nomatin/USB-RS485-Dongle/Docs/Световод цилиндрический XXXX.755453.001.pdf

### 1. Изготовить из прозрачного бесцветного прутка

полиметилметакрилата.
2.Неуказанные предельные отклонения линейных размеров — по ГОСТ 30893.1-2002, класс m.

### 3. Торцевые поверхности отполировать до оптической

прозрачности.
4.Царапины, сколы, трещины и помутнения, ухудшающие светопропускание, не допускаются.
5. Боковую цилиндрическую поверхность оставить без обработки. 6.Заусенцы на торцах удалить, не нарушая геометрии детали.

Инв.№ подл. Подп.

и дата Взам.инв.№ Инв.№ дубл. Подп.

и дата

Н. контр. | Попов
Утв. | Лыткин
Копировал | Формат

Справ.

№

| | | | XXXX.755453.001
| | | | Световод цилиндрический | Лит. | Масса | Масштаб
Изм. Лист № докум. | | Подп. | Дата | | | | | 0.04 г | 4:1
Разраб. | Иванов
| Пров. | Смирнов
Т.контр. | | | | Лист | Листов 1
| | | Полиметилметакрилат

Перв. примен.

XXXX.468352.001

A4

2

11
