nomatin/USB-RS485-Dongle/Board/OUTPUT/Manufacturing/BOM/Bill of Materials-USB_to_RS485.xlsx

Comment | Description | Designator | Package | Manufacturer | MPN | Quantity
100 нФ | Конденсатор 100 нФ ±20% 100 В X7R 0805, Конденсатор 100 нФ ±10% 100 В X7R 0805 | C1, C2, C4, C9, C10 | 0805 | YAGEO | CC0805MKX7R0BB104, CC0805KKX7R0BB104 | 5
4,7 мкФ | Конденсатор 4,7 мкФ ±20% 25 В X7R 0805 | C3, C5 | 0805 | YAGEO | CC0805MKX7R8BB475 | 2
10 мкФ | Конденсатор 10 мкФ ±20% 16 В X7R 0805 | C6, C13, C14 | 0805 | YAGEO | CC0805MKX7R7BB106 | 3
1 мкФ | Конденсатор 1 мкФ ±20% 100 В X7R 0805 | C7, C12 | 0805 | YAGEO | CC0805MKX7R0BB105 | 2
10 нФ | Конденсатор 10 нФ ±10% 100 В X7R 0603 | C8, C11 | 0603 | YAGEO | CC0603KRX7R0BB103 | 2
USBLC6-2SC6 | Микросхема USBLC6-2SC6 | D1 | SOT23-6L | STMicroelectronics | USBLC6-2SC6 | 1
CDSOT23-SM712 | TVS-сборка CDSOT23-SM712 | D2 | SOT23-3 | Bourns | CDSOT23-SM712 | 1
CP2102N-A02-GQFN24 | Микросхема CP2102N-A02-GQFN24 | D3 | QFN-24 4×4 mm, EP | Silicon Labs | CP2102N-A02-GQFN24 | 1
ISOW1432DFMR | Микросхема ISOW1432DFMR | D4 | SOIC-20 DFM (7,5×12,83 мм) | Texas Instruments | ISOW1432DFMR | 1
600 Ом @ 100 МГц | Ферритовый фильтр MPZ2012S601AT000 | L1 | 0805 | TDK | MPZ2012S601AT000 | 1
330 Ом @ 100 МГц | Ферритовый фильтр BLM21PG331SN1D | L2, L3 | 0805 | Murata | BLM21PG331SN1D | 2
5,1 кОм | Резистор 5,1 кОм ±5% 0805 | R1, R2 | 0805 | YAGEO | RC0805JR-075K1L | 2
330 Ом | Резистор 330 Ом ±5% 0805 | R3 | 0805 | YAGEO | RC0805JR-07330RL | 1
10 кОм | Резистор 10 кОм ±5% 0805 | R4, R6 | 0805 | YAGEO | RC0805JR-0710KL | 2
0 Ом | Резистор 0 Ом 0805 | R5 | 0805 | YAGEO | RC0805JR-070RL | 1
120 Ом | Резистор 120 Ом ±5% 0805 | R7 | 0805 | YAGEO | RC0805JR-07120RL | 1
22 кОм | Резистор 22 кОм ±5% 0805 | R8 | 0805 | YAGEO | RC0805JR-0722KL | 1
47 кОм | Резистор 47 кОм ±5% 0805 | R9 | 0805 | YAGEO | RC0805JR-0747KL | 1
1 кОм | Резистор 1 кОм ±5% 0805 | R10 | 0805 | YAGEO | RC0805JR-071KL | 1
4,7 кОм | Резистор 4,7 кОм ±5% 0805 | R11 | 0805 | YAGEO | RC0805JR-074K7L | 1
DS1040-01RT | Переключатель DS1040-01RT | SA1 | Piano DIP, THT, 2 вывода | CONNFLY | DS1040-01RT | 1
TO-2013BC-PG | Светодиод Чистый зелёный 3,2В 705мкд 0805 | VD1, VD2, VD3 | 0805 | Oasistek | TO-2013BC-PG | 3
USB Type-C | Разъём USB Type-C USB4110-GF-A | XS1 | USB Type-C, SMT | GCT | USB4110-GF-A | 1
D-SUB 9F | Разъём D-SUB 9F DS1037-01-09F | XS2 | D-SUB-9, угловая розетка, THT | CONNFLY | DS1037-01-09F | 1
