nomatin/USB-RS485-Dongle/Docs/Преобразователь USB–RS485 XXXX.426477.001 ПЭ3.xls

Sheet: XXXX.426477.001. Первый лист.
Перв. примен. | XXXX.426477.001 | Поз. обозна-чение |  |  | Наименование |  |  |  | Кол. |  | Примечание
 |  |  |  |  | Конденсаторы
 |  | C1,C2 |  |  | Конденсатор 100 нФ ±20% 100 В X7R 0805 |  |  |  | 2
 |  | C3 |  |  | Конденсатор 4,7 мкФ ±20% 25 В X7R 0805 |  |  |  | 1
Справ. № |  | C4 |  |  | Конденсатор 100 нФ ±20% 100 В X7R 0805 |  |  |  | 1
 |  | C5 |  |  | Конденсатор 4,7 мкФ ±20% 25 В X7R 0805 |  |  |  | 1
 |  | C6 |  |  | Конденсатор 10 мкФ ±20% 16 В X7R 0805 |  |  |  | 1
 |  | C7 |  |  | Конденсатор 1 мкФ ±20% 100 В X7R 0805 |  |  |  | 1
 |  | C8 |  |  | Конденсатор 10 нФ ±10% 100 В X7R 0603 |  |  |  | 1
 |  | C9,C10 |  |  | Конденсатор 100 нФ ±10% 100 В X7R 0805 |  |  |  | 2
 |  | C11 |  |  | Конденсатор 10 нФ ±10% 100 В X7R 0603 |  |  |  | 1
 |  | C12 |  |  | Конденсатор 1 мкФ ±20% 100 В X7R 0805 |  |  |  | 1
 |  | C13,C14 |  |  | Конденсатор 10 мкФ ±20% 16 В X7R 0805 |  |  |  | 2
Подп. и дата |  |  |  |  | Микросхемы
 |  | D1 |  |  | Микросхема USBLC6-2SC6 |  |  |  | 1
 |  | D2 |  |  | TVS-сборка CDSOT23-SM712 |  |  |  | 1
Инв. № дубл. |  | D3 |  |  | Микросхема CP2102N-A02-GQFN24 |  |  |  | 1
 |  | D4 |  |  | Микросхема ISO W1432DFMR |  |  |  | 1
Взам. инв.№
Подп. и дата
 |  |  |  |  |  |  |  | XXXX.426477.001 ПЭ3
 |  | Изм. | Лист | № докум. |  | Подп. | Дата
Инв. № подл. |  | Разраб. |  | Иванов |  |  |  | Преобразователь USB–RS485 |  | Лит. |  | Лист | Листов
 |  | Пров. |  | Смирнов |  |  |  |  |  |  |  | 1 | 2
 |  | Н.контр |  | Попов
 |  | Утв. |  | Лыткин |  |  |  | Перечень элементов

Sheet: 2
 | Поз. обозна- чение |  |  | Наименование |  |  |  | Кол. | Примечание
 |  |  |  | Катушки индуктивности
 | L1 |  |  | Ферритовый фильтр MPZ2012S601AT000 |  |  |  | 1
 | L2,L3 |  |  | Ферритовый фильтр BLM21PG331SN1D |  |  |  | 2
 |  |  |  | Переключатели
 | SA1 |  |  | Переключатель DS1040-01RT |  |  |  | 1
 |  |  |  | Резисторы
 | R1,R2 |  |  | Резистор 5,1 кОм ±5% 0805 |  |  |  | 2
 | R3 |  |  | Резистор 330 Ом ±5% 0805 |  |  |  | 1
 | R4 |  |  | Резистор 10 кОм ±5% 0805 |  |  |  | 1
Подп. и дата | R5 |  |  | Резистор 0 Ом 0805 |  |  |  | 1
 | R6 |  |  | Резистор 10 кОм ±5% 0805 |  |  |  | 1
 | R7 |  |  | Резистор 120 Ом ±5% 0805 |  |  |  | 1
 | R8 |  |  | Резистор 22 кОм ±5% 0805 |  |  |  | 1
Инв. № дубл. | R9 |  |  | Резистор 47 кОм ±5% 0805 |  |  |  | 1
 | R10 |  |  | Резистор 1 кОм ±5% 0805 |  |  |  | 1
 | R11 |  |  | Резистор 4,7 кОм ±5% 0805 |  |  |  | 1
Взам. инв.№
 |  |  |  | Диоды
Подп. и дата | VD1-VD3 |  |  | Светодиод Чистый зелёный 3,2В 705мкд 0805 |  |  |  | 3
 |  |  |  | Соединители
 | XS1 |  |  | Разъём USB Type-C USB4110-GF-A |  |  |  | 1
Инв. № подл. | XS2 |  |  | Разъём D-SUB 9F DS1037-01-09F |  |  |  | 1
 |  |  |  |  |  |  | XXXX.426477.001 ПЭ3 |  |  | Лист
 |  |  |  |  |  |  |  |  |  | 2
 | Изм. | Лист | № докум. |  | Подп. | Дата
