nomatin/USB-RS485-Dongle/Docs/Преобразователь USB–RS485 XXXX.426477.001.xls

Sheet: XXXX.426477.001. Первый лист.
Перв. примен. | XXXX.426477.001 | Формат | Зона |  | Поз. |  | Обозначение |  |  |  | Наименование |  |  | Кол. | Примечание
 |  |  |  |  |  |  |  |  |  |  | Детали
 |  |  |  |  | 1 |  | XXXX.758765.001 |  |  |  | Плата печатная |  |  | 1
 |  |  |  |  |  |  |  |  |  |  | Прочие изделия
Справ. №
 |  |  |  |  |  |  |  |  |  |  | Конденсаторы
 |  |  |  |  | 2 |  |  |  |  |  | Конденсатор 10 нФ ±10% 100 |  |  | 2 | C8, C11
 |  |  |  |  |  |  |  |  |  |  | В X7R 0603
 |  |  |  |  | 3 |  |  |  |  |  | Конденсатор 100 нФ ±10% |  |  | 2 | C9, C10
 |  |  |  |  |  |  |  |  |  |  | 100 В X7R 0805
 |  |  |  |  | 4 |  |  |  |  |  | Конденсатор 100 нФ ±20% |  |  | 3 | C1, C2, C4
 |  |  |  |  |  |  |  |  |  |  | 100 В X7R 0805
 |  |  |  |  | 5 |  |  |  |  |  | Конденсатор 1 мкФ ±20% 100 |  |  | 2 | C7, C12
 |  |  |  |  |  |  |  |  |  |  | В X7R 0805
 |  |  |  |  | 6 |  |  |  |  |  | Конденсатор 4,7 мкФ ±20% |  |  | 2 | C3, C5
Подп. и дата |  |  |  |  |  |  |  |  |  |  | 25 В X7R 0805
 |  |  |  |  | 7 |  |  |  |  |  | Конденсатор 10 мкФ ±20% 16 |  |  | 3 | C6, C13, C14
 |  |  |  |  |  |  |  |  |  |  | В X7R 0805
Инв. № дубл. |  |  |  |  |  |  |  |  |  |  | Микросхемы
 |  |  |  |  | 8 |  |  |  |  |  | TVS-сборка CDSOT23-SM712 |  |  | 1 | D2
 |  |  |  |  | 9 |  |  |  |  |  | Микросхема |  |  | 1 | D3
Взам. инв. № |  |  |  |  |  |  |  |  |  |  | CP2102N-A02-GQFN24
Подп. и дата
 |  |  |  |  |  |  |  |  |  | XXXX.426477.001
 |  | Изм. |  | Лист |  | № докум. |  | Подп. | Дата
Инв. № подл. |  | Разраб. |  |  |  |  |  |  |  | Преобразователь USB–RS485 |  | Лит. | Лист |  |  | Листов
 |  | Пров. |  |  |  |  |  |  |  |  |  |  | 1 |  |  | 4
 |  | Н. контр.
 |  | Утв.

Sheet: 2
 | Формат | Зона |  | Поз. |  | Обозначение |  |  |  | Наименование | Кол. | Примечание
 |  |  |  |  |  |  |  |  |  | Микросхемы
 |  |  |  | 10 |  |  |  |  |  | Микросхема ISO W1432DFMR | 1 | D4
 |  |  |  | 11 |  |  |  |  |  | Микросхема USBLC6-2SC6 | 1 | D1
 |  |  |  |  |  |  |  |  |  | Катушки индуктивности
 |  |  |  | 12 |  |  |  |  |  | Ферритовый фильтр | 2 | L2, L3
 |  |  |  |  |  |  |  |  |  | BLM21PG331SN1D
 |  |  |  | 13 |  |  |  |  |  | Ферритовый фильтр | 1 | L1
 |  |  |  |  |  |  |  |  |  | MPZ2012S601AT000
 |  |  |  |  |  |  |  |  |  | Переключатели
 |  |  |  | 14 |  |  |  |  |  | Переключатель DS1040-01RT | 1 | SA1
 |  |  |  |  |  |  |  |  |  | Резисторы
 |  |  |  | 15 |  |  |  |  |  | Резистор 0 Ом 0805 | 1 | R5
 |  |  |  | 16 |  |  |  |  |  | Резистор 120 Ом ±5% 0805 | 1 | R7
 |  |  |  | 17 |  |  |  |  |  | Резистор 330 Ом ±5% 0805 | 1 | R3
Подп. и дата |  |  |  | 18 |  |  |  |  |  | Резистор 1 кОм ±5% 0805 | 1 | R10
 |  |  |  | 19 |  |  |  |  |  | Резистор 4,7 кОм ±5% 0805 | 1 | R11
 |  |  |  | 20 |  |  |  |  |  | Резистор 5,1 кОм ±5% 0805 | 2 | R1, R2
 |  |  |  | 21 |  |  |  |  |  | Резистор 10 кОм ±5% 0805 | 2 | R4, R6
Инв. № дубл. |  |  |  | 22 |  |  |  |  |  | Резистор 22 кОм ±5% 0805 | 1 | R8
 |  |  |  | 23 |  |  |  |  |  | Резистор 47 кОм ±5% 0805 | 1 | R9
Взам. инв. № |  |  |  |  |  |  |  |  |  | Диоды
 |  |  |  | 24 |  |  |  |  |  | Светодиод Чистый зелёный | 3 | VD1-VD3
 |  |  |  |  |  |  |  |  |  | 3,2В 705мкд 0805
Подп. и дата
Инв. № подл.
 |  |  |  |  |  |  |  |  | XXXX.426477.001 |  |  |  | Лист
 |  |  |  |  |  |  |  |  |  |  |  |  | 2
 | Изм. |  | Лист |  | № докум. |  | Подп. | Дата

Sheet: 3
 | Формат | Зона |  | Поз. |  | Обозначение |  |  |  | Наименование | Кол. | Примечание
 |  |  |  |  |  |  |  |  |  | Соединители
 |  |  |  | 25 |  |  |  |  |  | Разъём D-SUB 9F | 1 | XS2
 |  |  |  |  |  |  |  |  |  | DS1037-01-09F
 |  |  |  | 26 |  |  |  |  |  | Разъём USB Type-C | 1 | XS1
 |  |  |  |  |  |  |  |  |  | USB4110-GF-A
Подп. и дата
Инв. № дубл.
Взам. инв. №
Подп. и дата
Инв. № подл.
 |  |  |  |  |  |  |  |  | XXXX.426477.001 |  |  |  | Лист
 |  |  |  |  |  |  |  |  |  |  |  |  | 3
 | Изм. |  | Лист |  | № докум. |  | Подп. | Дата

Sheet: Лист регистрации изменений.
 | Лист регистрации изменений
 | Изм. |  | Номера листов (страниц) |  |  |  |  |  |  |  | Всего листов (страниц) в докум. | № докум. | Входящий № сопроводи- тельного документа и дата | Под- пись | Дата
 |  |  | изме- ненных |  | заме- няемых |  | новых |  |  | аннули-рованных
Подп. и дата
Инв. № дубл.
Взам. инв. №
Подп. и дата
Инв.№ подл.
 |  |  |  |  |  |  |  |  | XXXX.426477.001 |  |  |  |  |  |  | Лист
 |  |  |  |  |  |  |  |  |  |  |  |  |  |  |  | 4
 | Изм. | Лист |  | № докум |  | Подп. |  | Дата
