nomatin/USB-RS485-Dongle/Board/3D/PCB.step

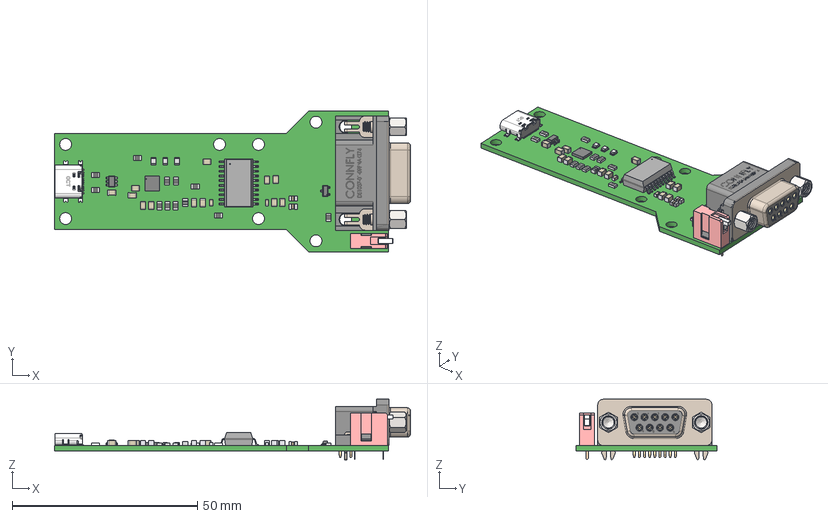
[picture p5: CAD file, 2026-11-06]
Board/3D/PCB.step
96.0 x 38.0 x 16.3 mm
TDK_MPZ2012S_2012
Murata_BLM21PG_2012_Reflow x 2
USB4110-GF-A
Extruded x 9
CONNFLY_DS1040_01RT
RES 0805 (2012 metric) x 11
Leader x 6
CAP_0805 x 12
CAP_0603 x 2
