nomatin/USB-RS485-Dongle/(list of files, cad)

Other CAD files:
Board/3D/PCB.DXF
