nomatin/USB-RS485-Dongle/Board/OUTPUT/Schematics.PDF

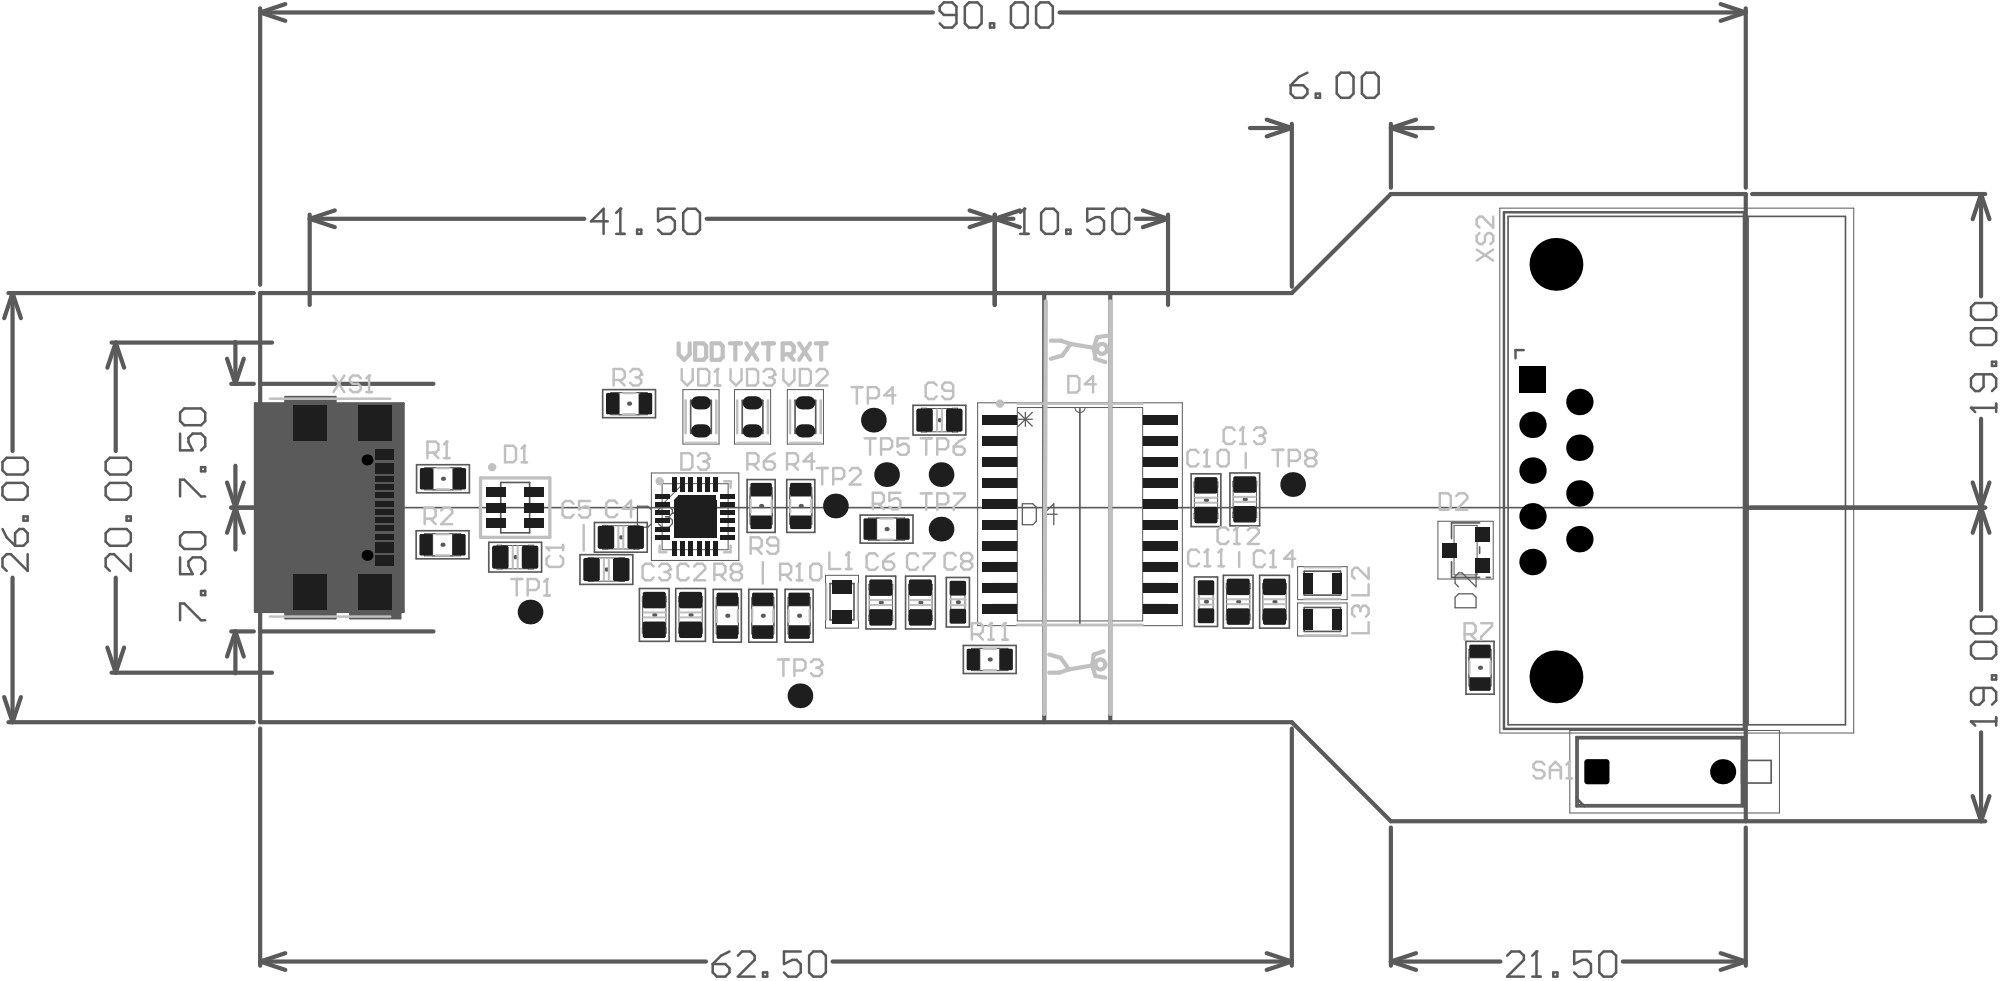
[picture p6: page 1]

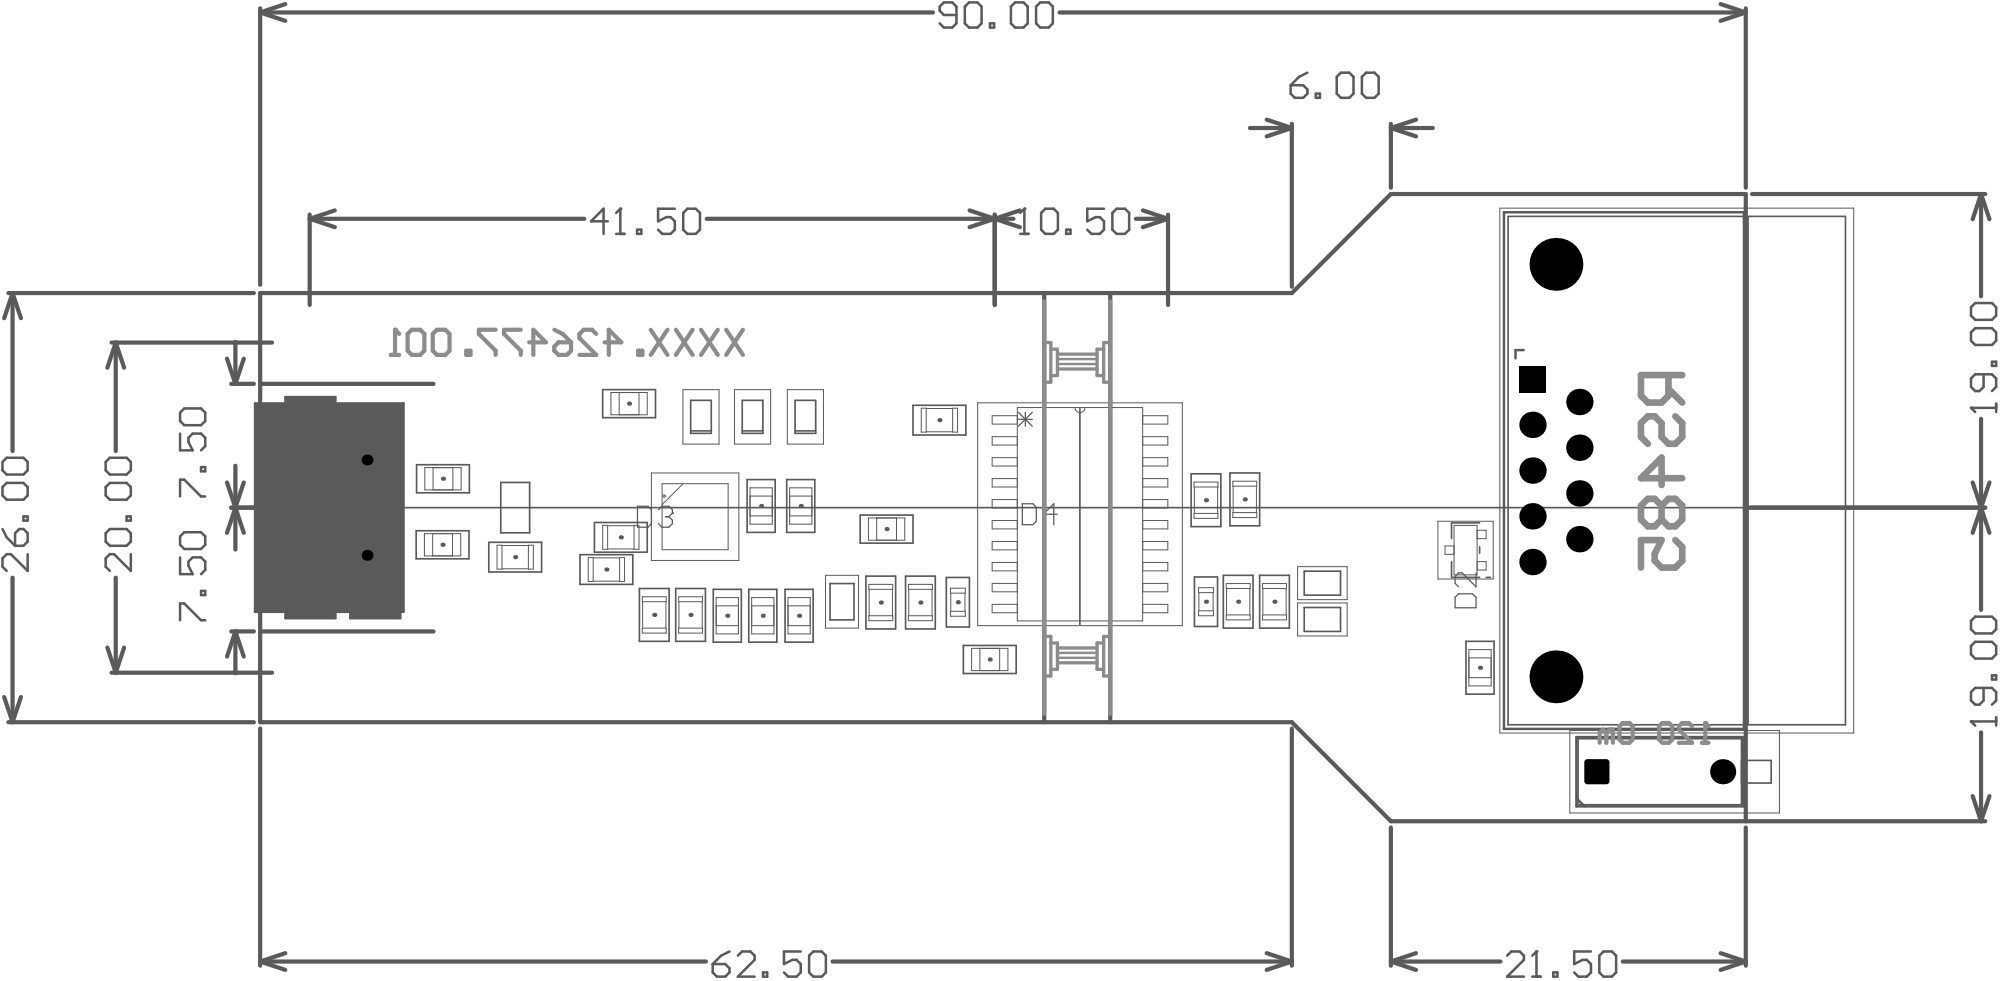
[picture p7: page 2]
