nomatin/USB-RS485-Dongle/Docs/Крышка нижняя XXXX.741374.004.pdf

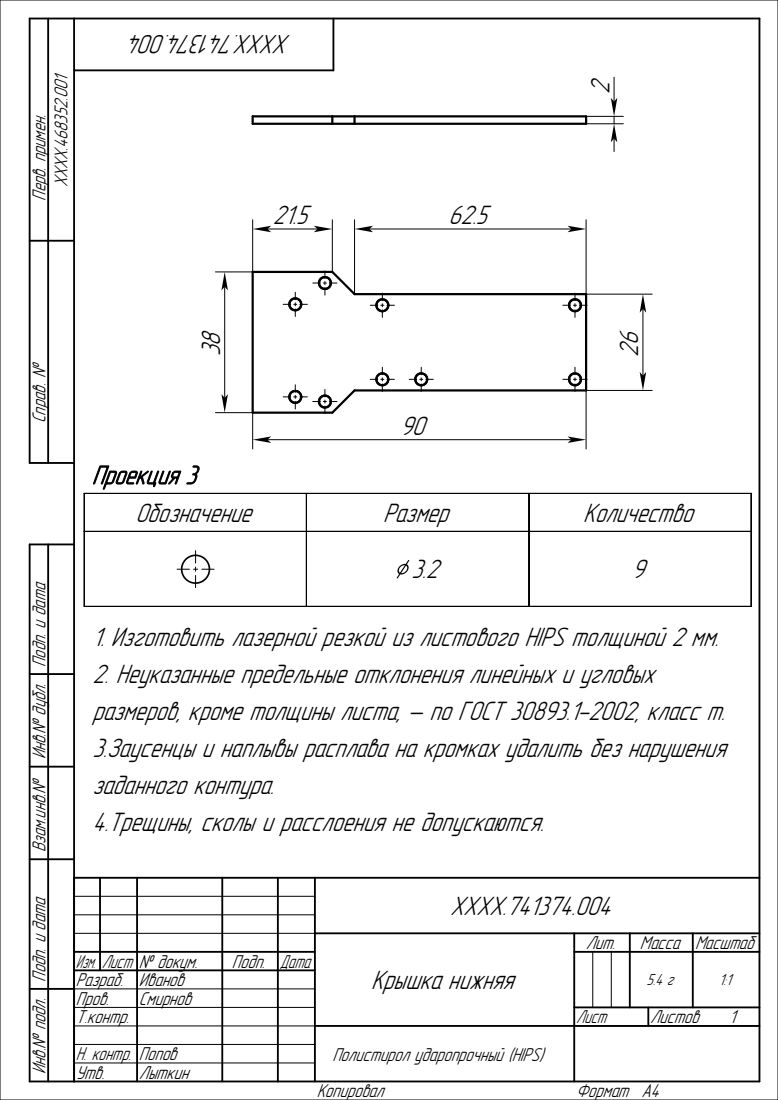
[picture p10: page 1]
Проекция 3; Копировал; Формат; Справ.; Перв. примен.; XXXX.468352.001

Обозначение | Размер | Количество

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

и дата Взам.инв.№ Инв.№ дубл. Подп.

XXXX.741374.004

Крышка нижняя | Лит. | Масса | Масштаб

Инв.№ подл. Подп.

Изм. Лист № докум. | | Подп. | Дата | | | | | 5.4 г | 1:1
Разраб. | Иванов
Пров. | Смирнов
Т.контр. | | | | Лист | Листов 1
Н. контр. | Попов
Утв. | Лыткин

Полистирол ударопрочный (HIPS)
