nomatin/USB-RS485-Dongle/Docs/Пластина защитная XXXX.741374.003.pdf

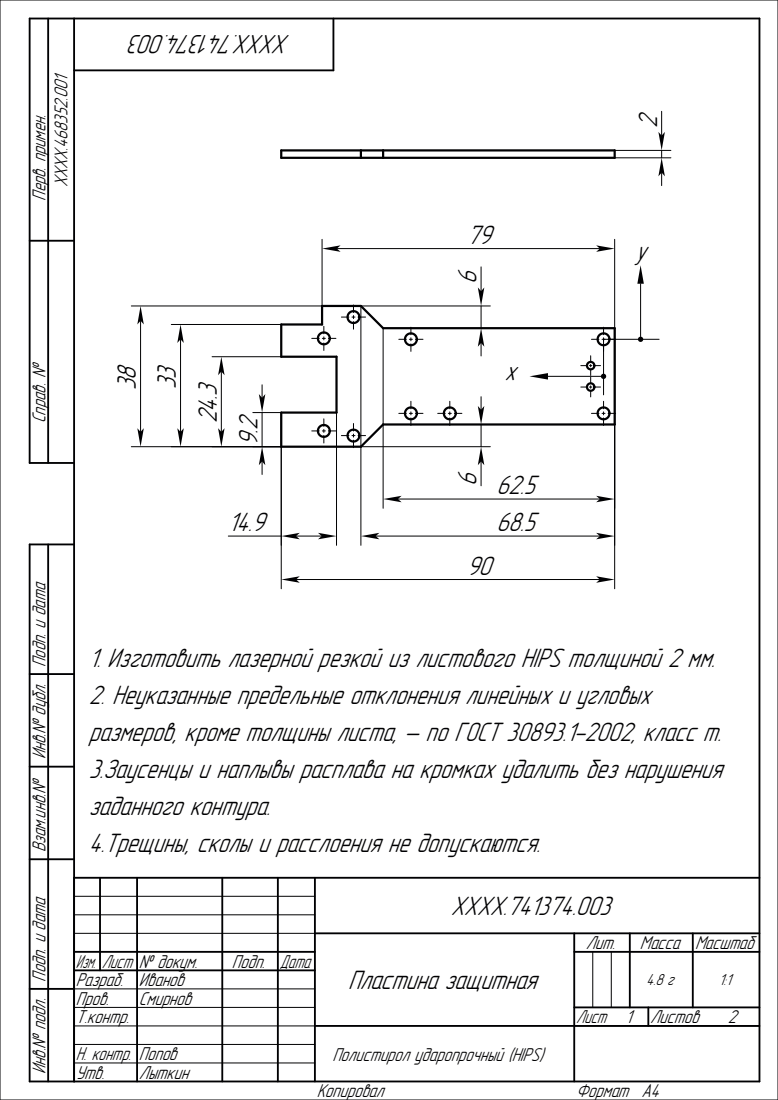
[picture p11: page 1]
и дата; Копировал; Формат; Справ.; Перв. примен.; XXXX.468352.001

и дата Взам.инв.№ Инв.№ дубл. Подп.
1. Изготовить лазерной резкой из листового HIPS толщиной 2 мм.
2. Неуказанные предельные отклонения линейных и угловых
размеров, кроме толщины листа, — по ГОСТ 30893.1-2002, класс m.
3.Заусенцы и наплывы расплава на кромках удалить без нарушения
заданного контура.
4.Трещины, сколы и расслоения не допускаются.

XXXX.741374.003

Пластина защитная | Лит. | Масса | Масштаб

Инв.№ подл. Подп.

Изм. Лист № докум. | | Подп. | Дата | | | | | 4.8 г | 1:1
Разраб. | Иванов
Пров. | Смирнов
Т.контр. | | | | Лист 1 2 | Листов
Н. контр. | Попов
Утв. | Лыткин

Полистирол ударопрочный (HIPS)

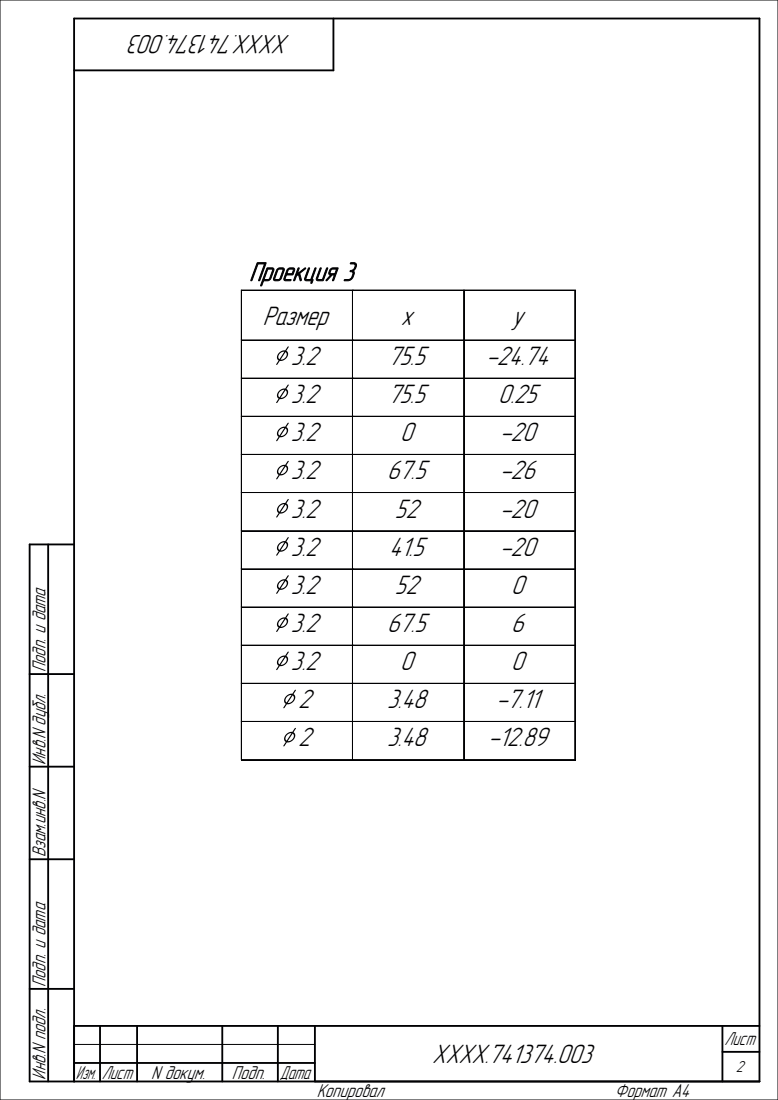
[picture p12: page 2]
Проекция 3; и дата; Копировал; Формат; XXXX.741374.003; Лист; Изм. Лист; N докум.; Подп.; Дата

Размер | x | y
3.2 | 75.5 | -24.74
3.2 | 75.5 | 0.25
3.2 | 0 | -20
3.2 | 67.5 | -26
3.2 | 52 | -20
3.2 | 41.5 | -20
3.2 | 52 | 0
3.2 | 67.5 | 6
3.2 | 0 | 0
2 | 3.48 | -7.11
2 | 3.48 | -12.89

и дата Взам.инв.N Инв.N дубл. Подп.

Инв.N подл. Подп.
