nomatin/USB-RS485-Dongle/Docs/Пластина удерживающая XXXX.741374.004.pdf

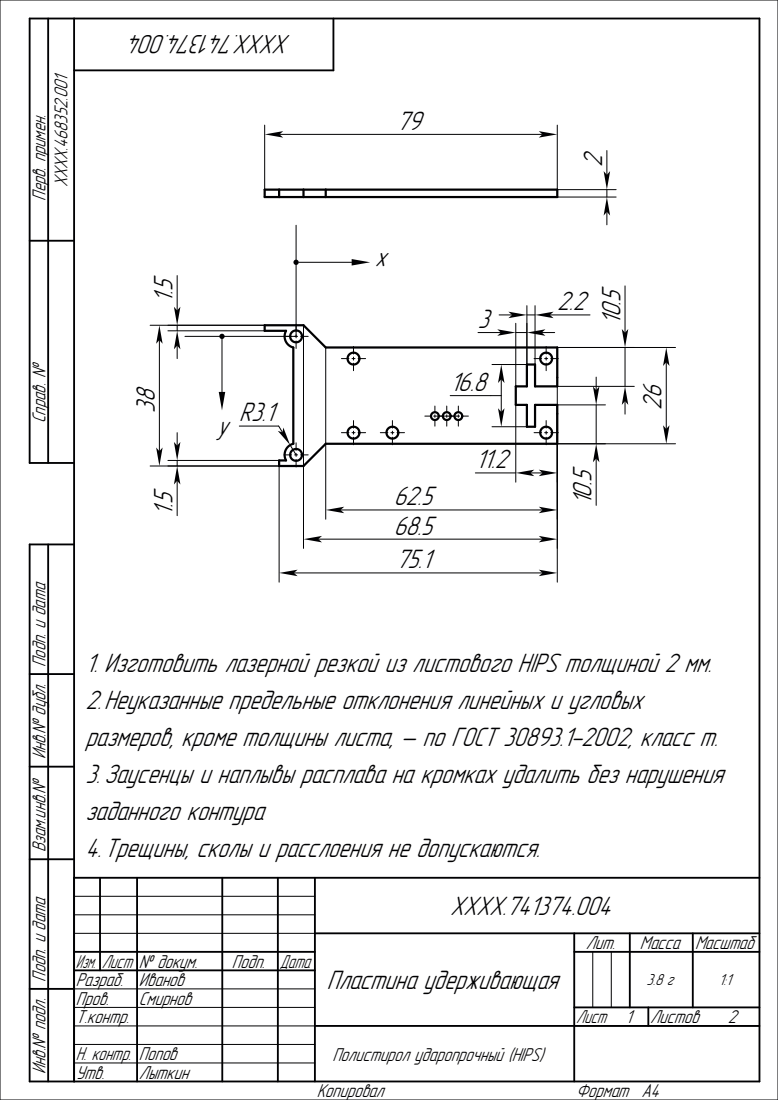
[picture p13: page 1]
и дата; Копировал; Формат; Справ.; Перв. примен.; XXXX.468352.001

и дата Взам.инв.№ Инв.№ дубл. Подп.
1. Изготовить лазерной резкой из листового HIPS толщиной 2 мм.
2.Неуказанные предельные отклонения линейных и угловых
размеров, кроме толщины листа, — по ГОСТ 30893.1-2002, класс m.
3. Заусенцы и наплывы расплава на кромках удалить без нарушения
заданного контура
4.Трещины, сколы и расслоения не допускаются.

XXXX.741374.004

Пластина удерживающая | Лит. | Масса | Масштаб

Инв.№ подл. Подп.

Изм. Лист № докум. | | Подп. | Дата | | | | | 3.8 г | 1:1
Разраб. | Иванов
Пров. | Смирнов
Т.контр. | | | | Лист 1 2 | Листов
Н. контр. | Попов
Утв. | Лыткин

Полистирол ударопрочный (HIPS)

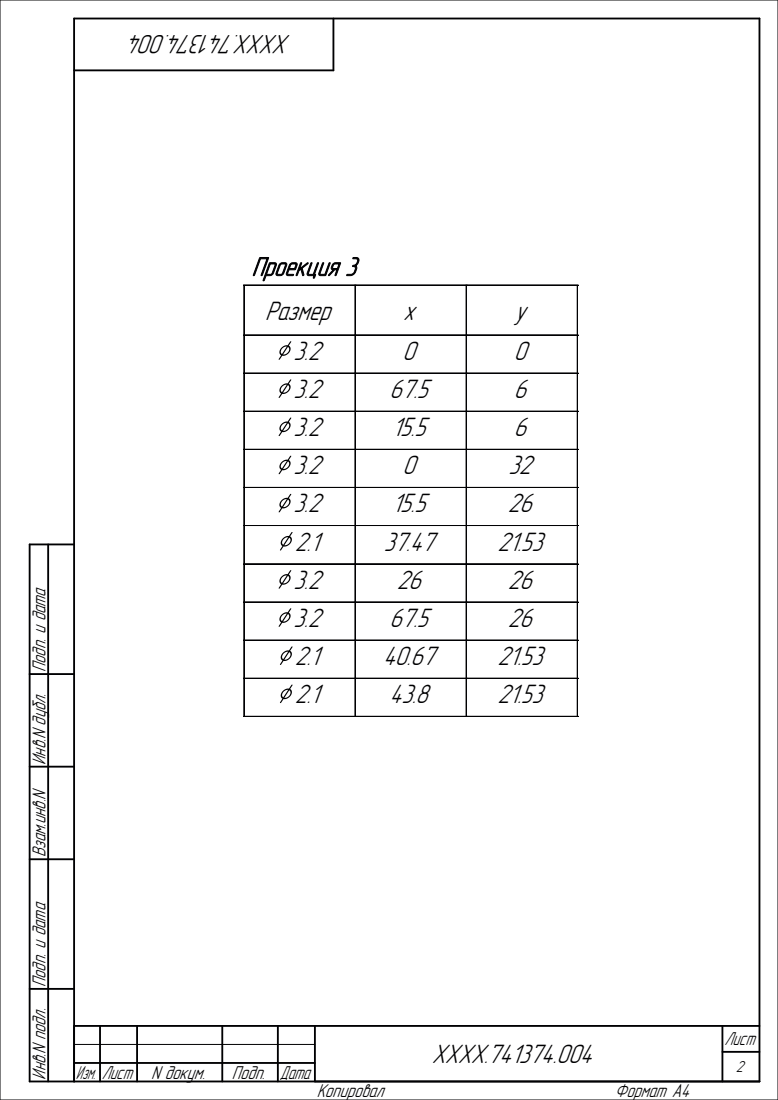
[picture p14: page 2]
Проекция 3; и дата; Копировал; Формат; XXXX.741374.004; Лист; Изм. Лист; N докум.; Подп.; Дата

Размер | x | y
3.2 | 0 | 0
3.2 | 67.5 | 6
3.2 | 15.5 | 6
3.2 | 0 | 32
3.2 | 15.5 | 26
2.1 | 37.47 | 21.53
3.2 | 26 | 26
3.2 | 67.5 | 26
2.1 | 40.67 | 21.53
2.1 | 43.8 | 21.53

и дата Взам.инв.N Инв.N дубл. Подп.

Инв.N подл. Подп.
