nomatin/USB-RS485-Dongle/Docs/Сборочный чертеж XXXX.468352.001 СБ.pdf

95.99
А

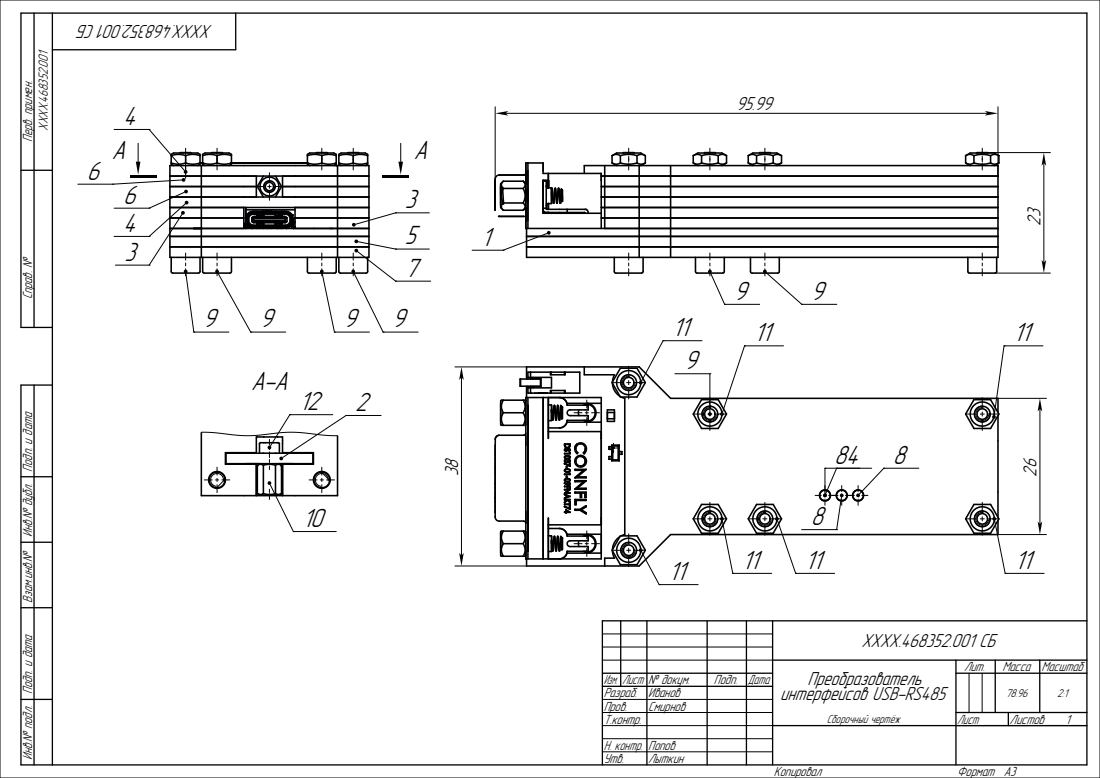
[picture p17: page 1]
Справ. №; Перв. примен.; XXXX.468352.001

Инв.№ подл. Подп. и дата Взам.инв.№ Инв.№ дубл. Подп. и дата

XXXX.468352.001 СБ

Преобразователь интерфейсов USB–RS485 Сборочный чертёж | Лит. | Масса | Масштаб

Изм. Лист | № докум. | Подп. | Дата | | | | | 78.96 2:1
Разраб. | Иванов
Пров. | Смирнов
Т.контр. | | | | Лист | Листов 1
Н. контр. | Попов
Утв. | Лыткин

Копировал Формат A3
