nomatin/USB-RS485-Dongle/Docs/Сборочный чертеж XXXX.468352.001.pdf

## Утв. Формат Зона

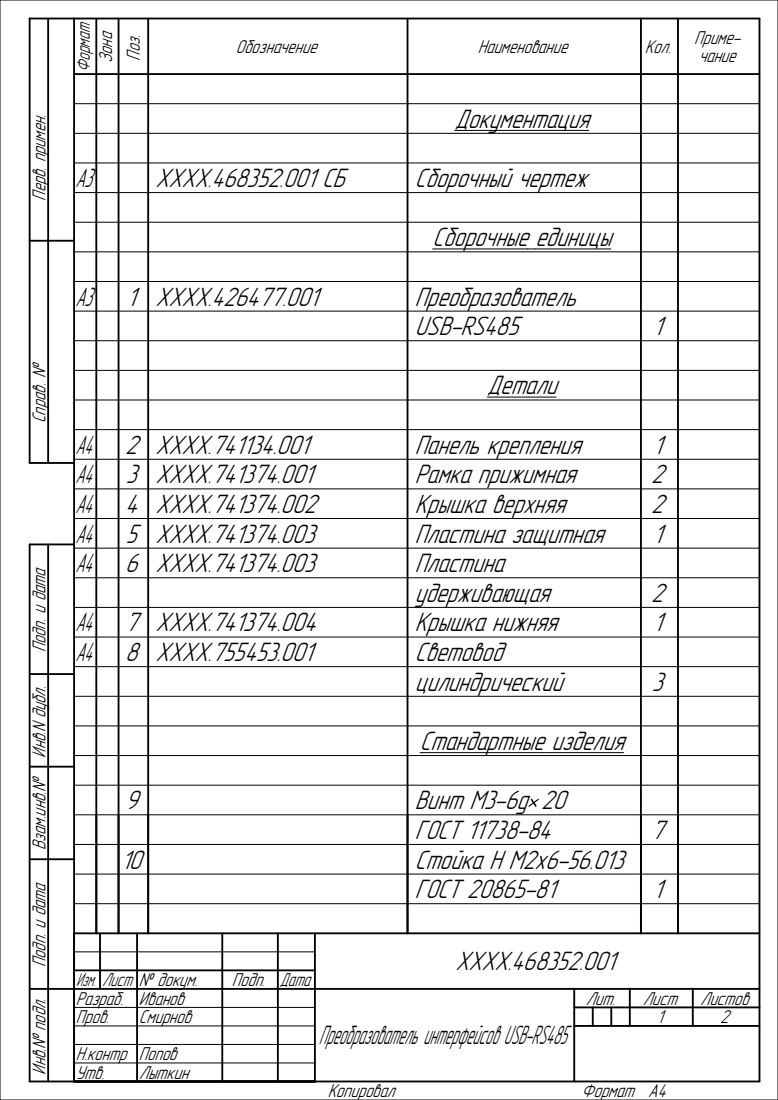
[picture p18: page 1]
Документация; XXXX.468352.001 СБ; Сборочный чертеж; Сборочные единицы; Детали; Стандартные изделия; и дата; Копировал; Формат; Поз.; Обозначение; Наименование; Кол.; Приме- чание; Справ.; № Перв. примен.

A3 | 1 | XXXX.426477.001 | Преобразователь

USB–RS485 | 1

A4 | 2 XXXX.741134.001 | | Панель крепления | 1
A4 | 3 | XXXX.741374.001 | Рамка прижимная | 2
A4 | 4 XXXX.741374.002 | | Крышка верхняя | 2
A4 | 5 | XXXX.741374.003 | Пластина защитная | 1
A4 | 6 XXXX.741374.003 | | Пластина

удерживающая | 2

A4 | 7 XXXX.741374.004 | | Крышка нижняя | 1
A4 | 8 XXXX.755453.001 | | Световод

и дата Взам.инв.№ Инв.N дубл. Подп.

цилиндрический | 3

9 Винт M3-6g 20

ГОСТ 11738-84 | 7

10 Стойка Н М2x6-56.013

ГОСТ 20865-81 | 1

Инв.№ подл. Подп.

XXXX.468352.001

Изм. Лист № докум. | | | Подп. | Дата
Разраб. | Иванов | | Преобразователь интерфейсов USB–RS485 | Лит. | Лист | Листов
Пров. | Смирнов | | | | | | 1 | 2
Н.контр | Попов

Лыткин

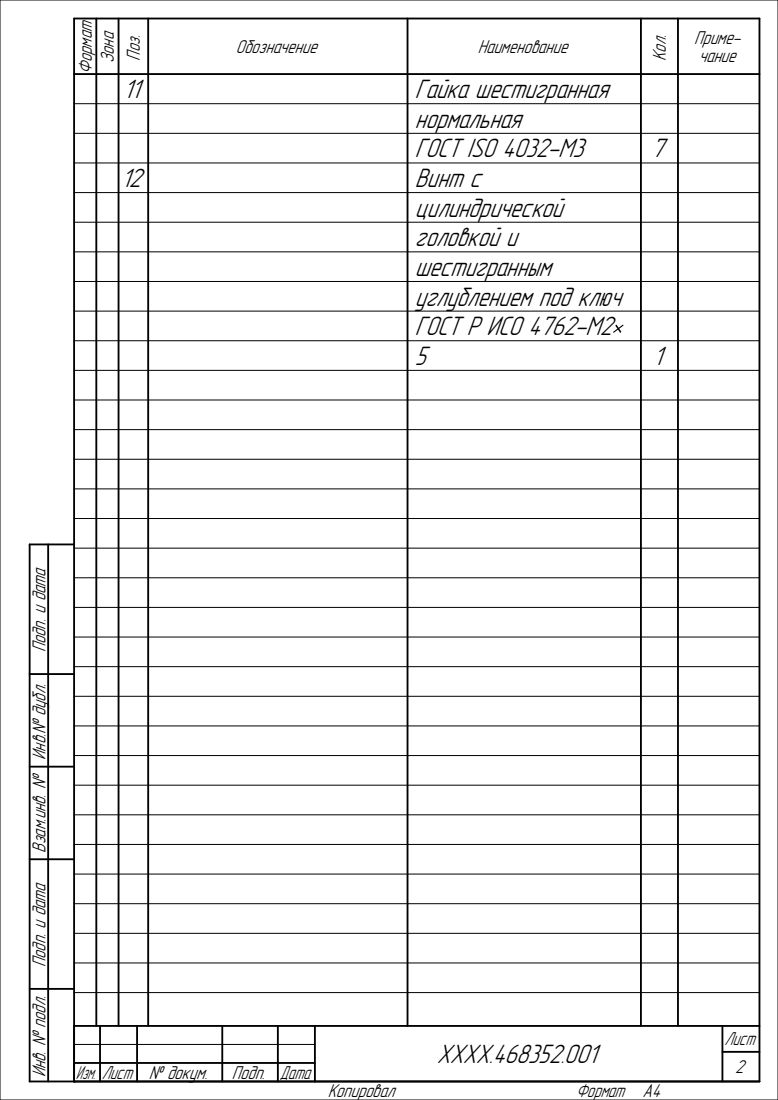
[picture p19: page 2]
Инв.; № подл. Подп.; и дата; Копировал; Формат; XXXX.468352.001; Лист; Изм. Лист; № докум.; Подп.; Дата; Зона; Поз.; Кол.

Обозначение | Наименование | | Приме-чание

11 Гайка шестигранная

нормальная
ГОСТ ISO 4032-M3 | 7

12 Винт с

цилиндрической
головкой и
шестигранным
углублением под ключ
ГОСТ Р ИСО 4762-M2
5 1

№ Инв.№ дубл. Подп.

и дата Взам.инв.
