nomatin/USB-RS485-Dongle/Docs/Плата печатная XXXX.758765.001.PDF

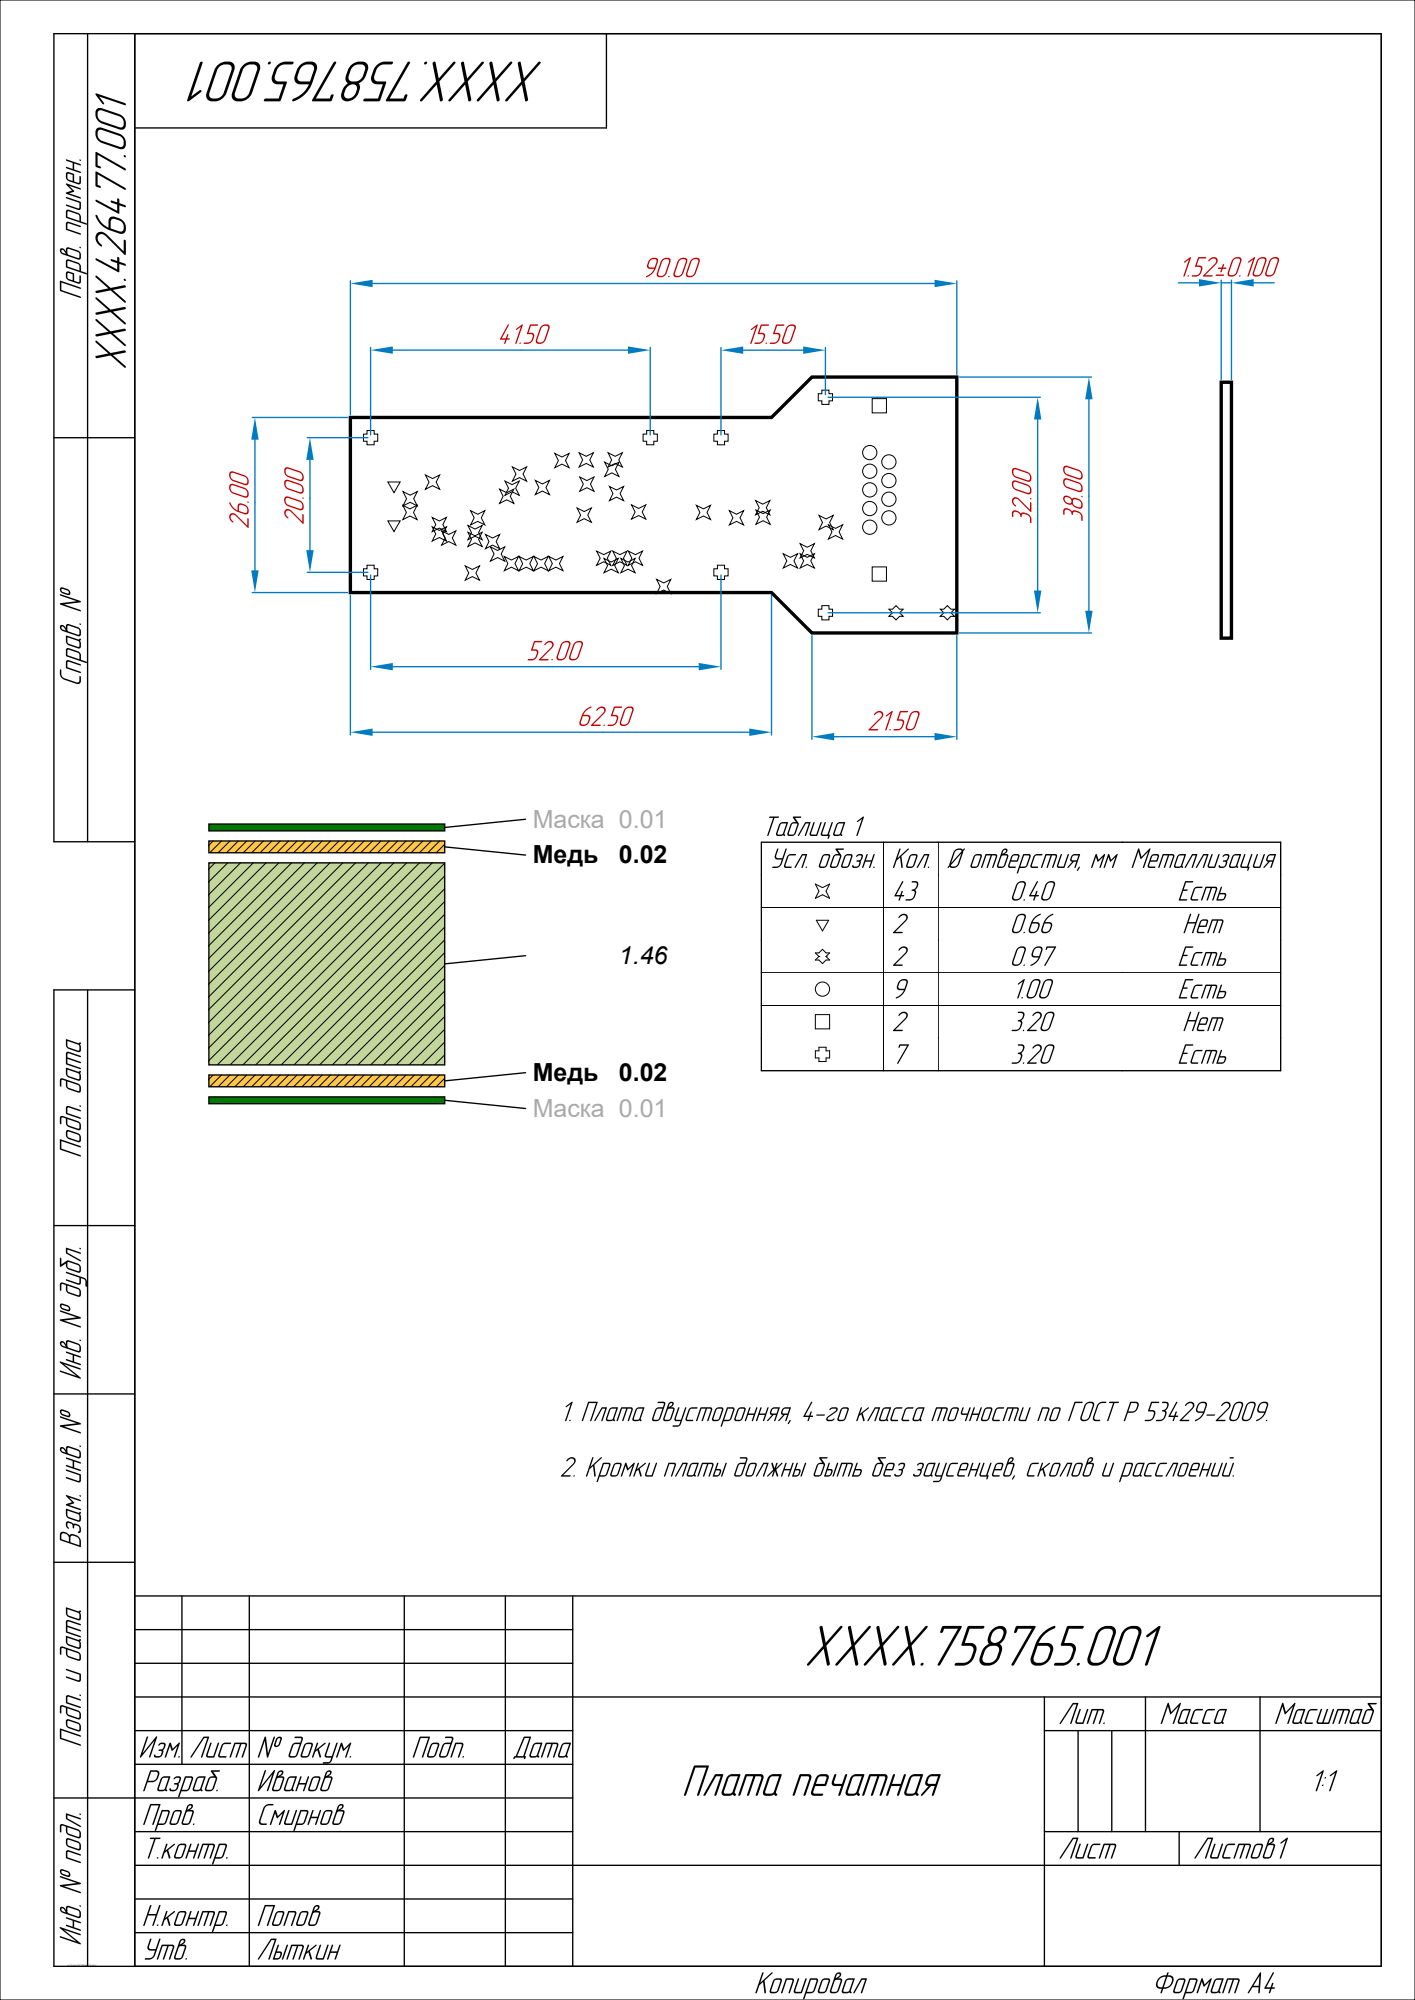
[picture p22: page 1]
