nomatin/USB-RS485-Dongle/Docs/Преобразователь USB–RS485 XXXX.426477.001 СБ.PDF

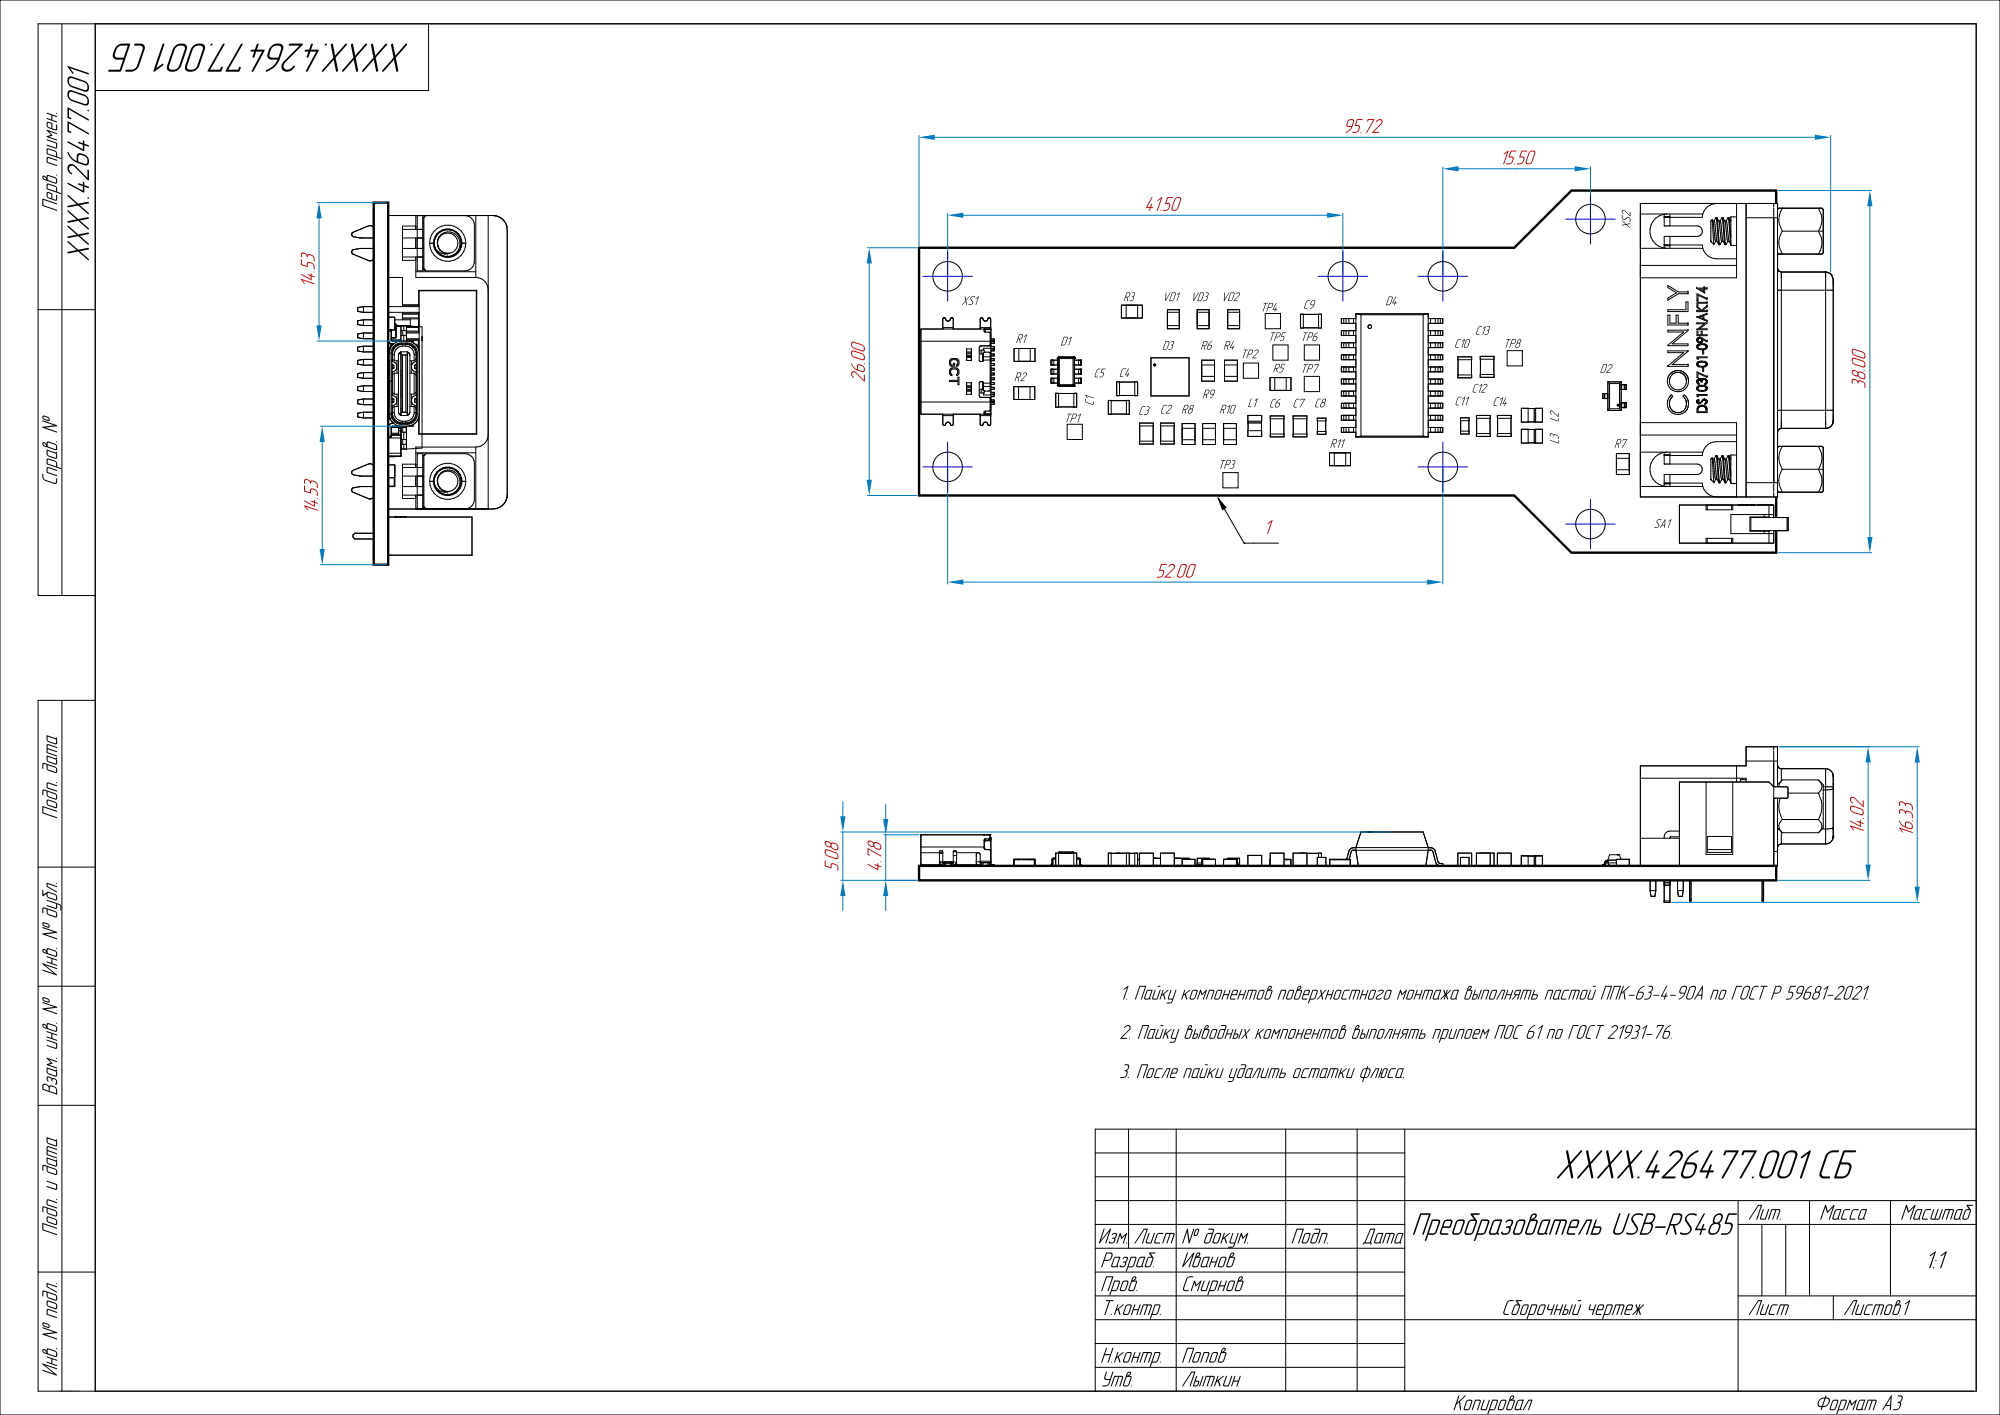
[picture p23: page 1]
