nomatin/USB-RS485-Dongle/Docs/Преобразователь USB–RS485 XXXX.426477.001 Э3.PDF

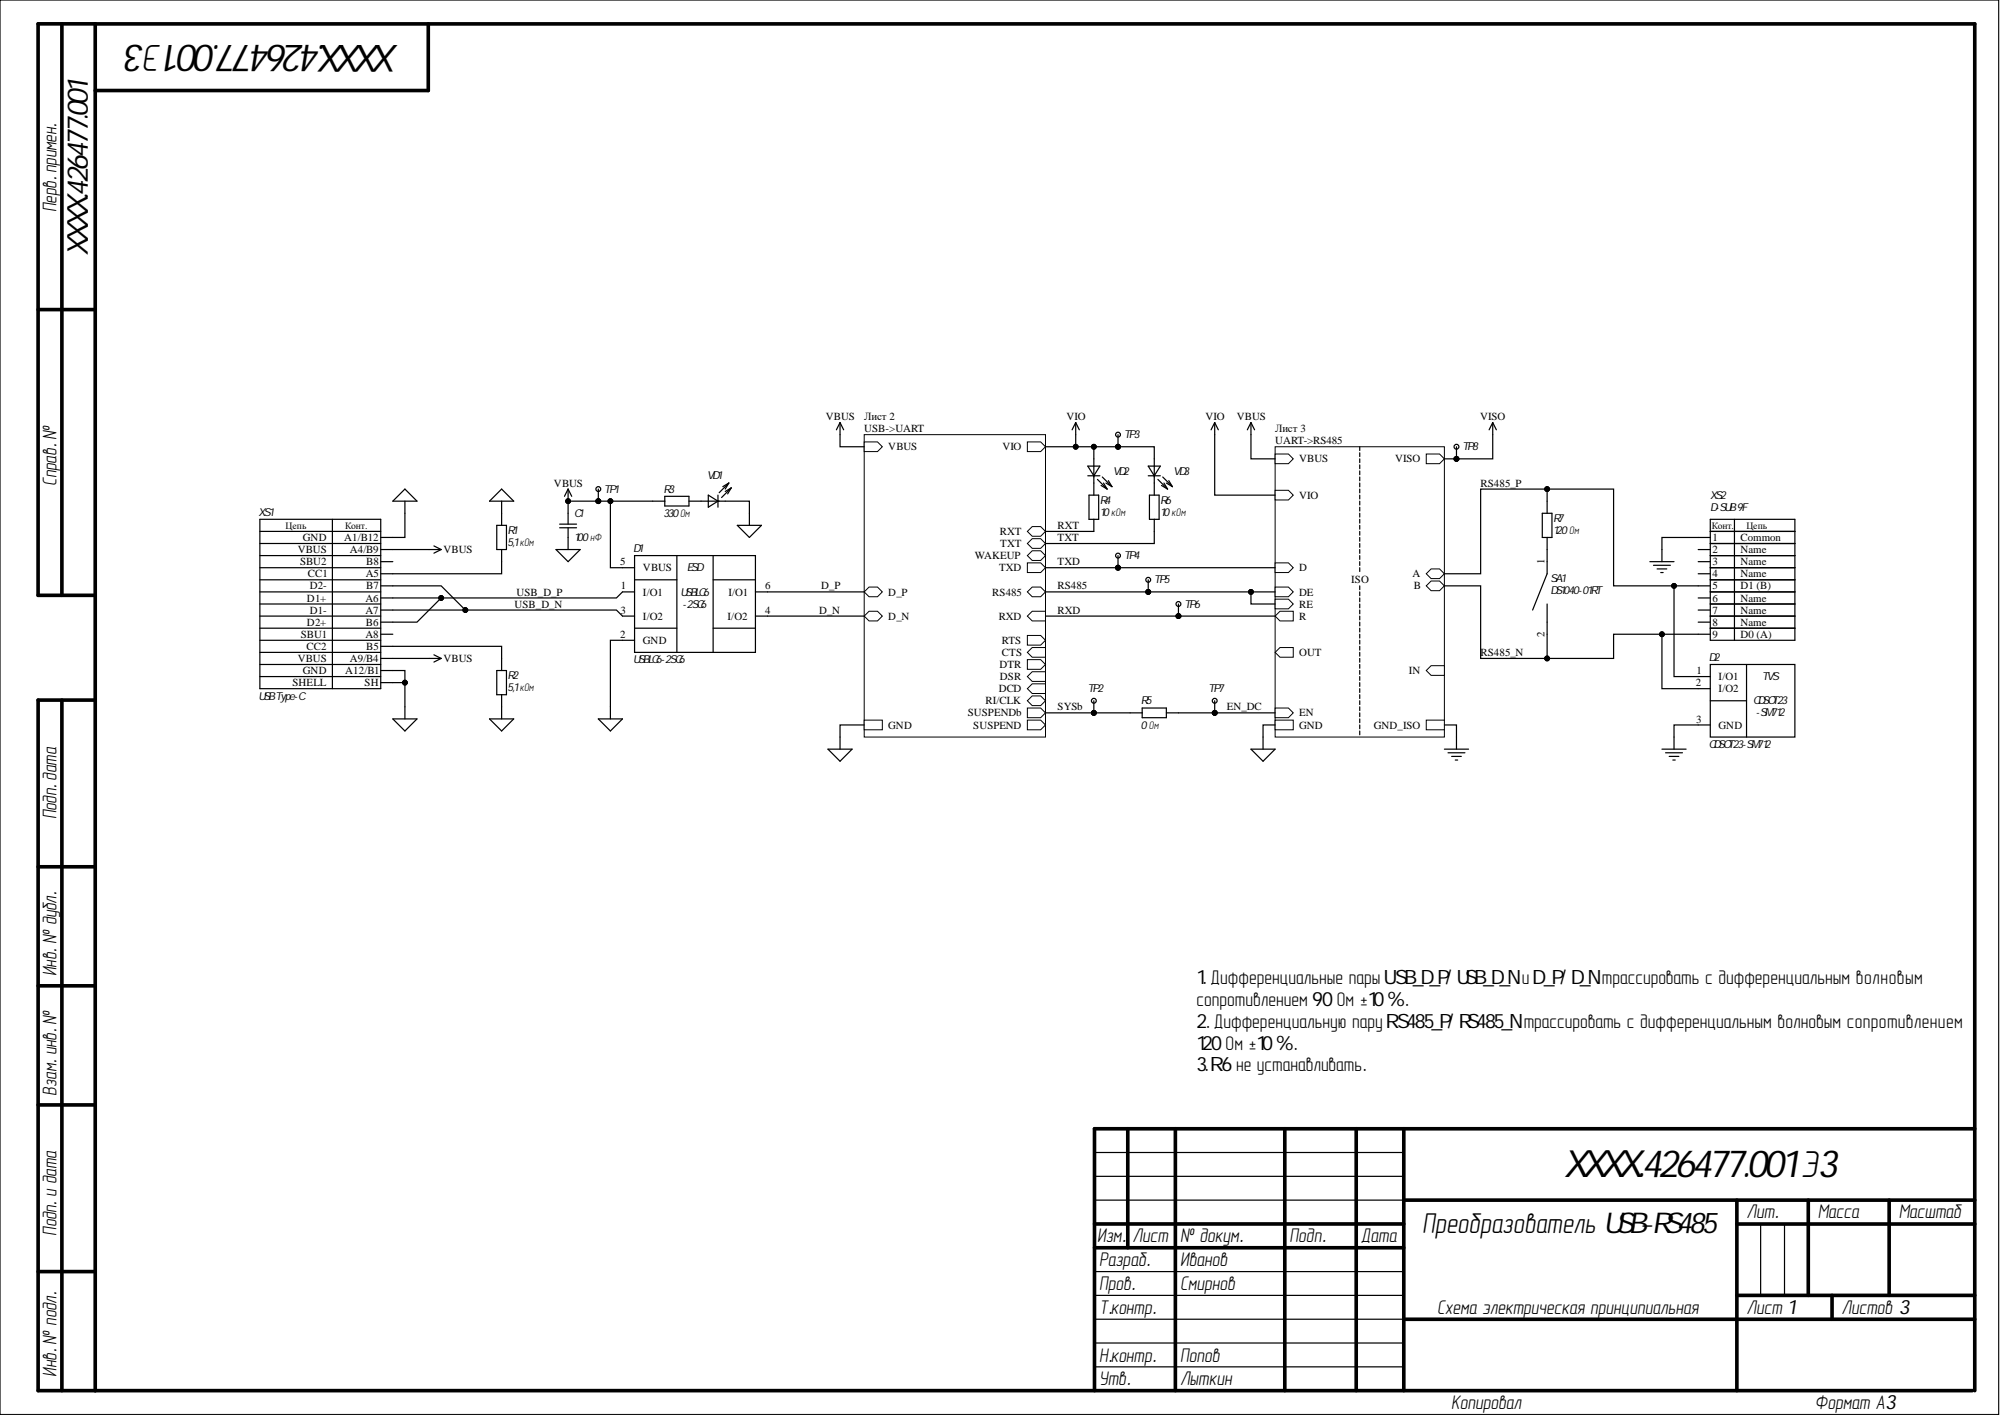
[picture p24: page 1]

Инв.№ подл. Подп.и дата Взам.инв.№ Инв.№ дубл. Подп.дата Справ.№ Перв.примен.

XS2 D-SUB
Name Name Name D1 (B) Name Name Name

CC2 | B5
VBU S | A 9 /B 4

Схема электрическая принципиальная XXXX.426477.001

Преобразователь USB– RS485 | Лит . | Масса | Масштаб

Изм . Лист | № докум . | Подп . | Дата
Разраб . | Иванов
Пров . | Смирнов
Т .контр . | | | | Лист | Листов

Н .контр | Попов
Утв | Лыткин

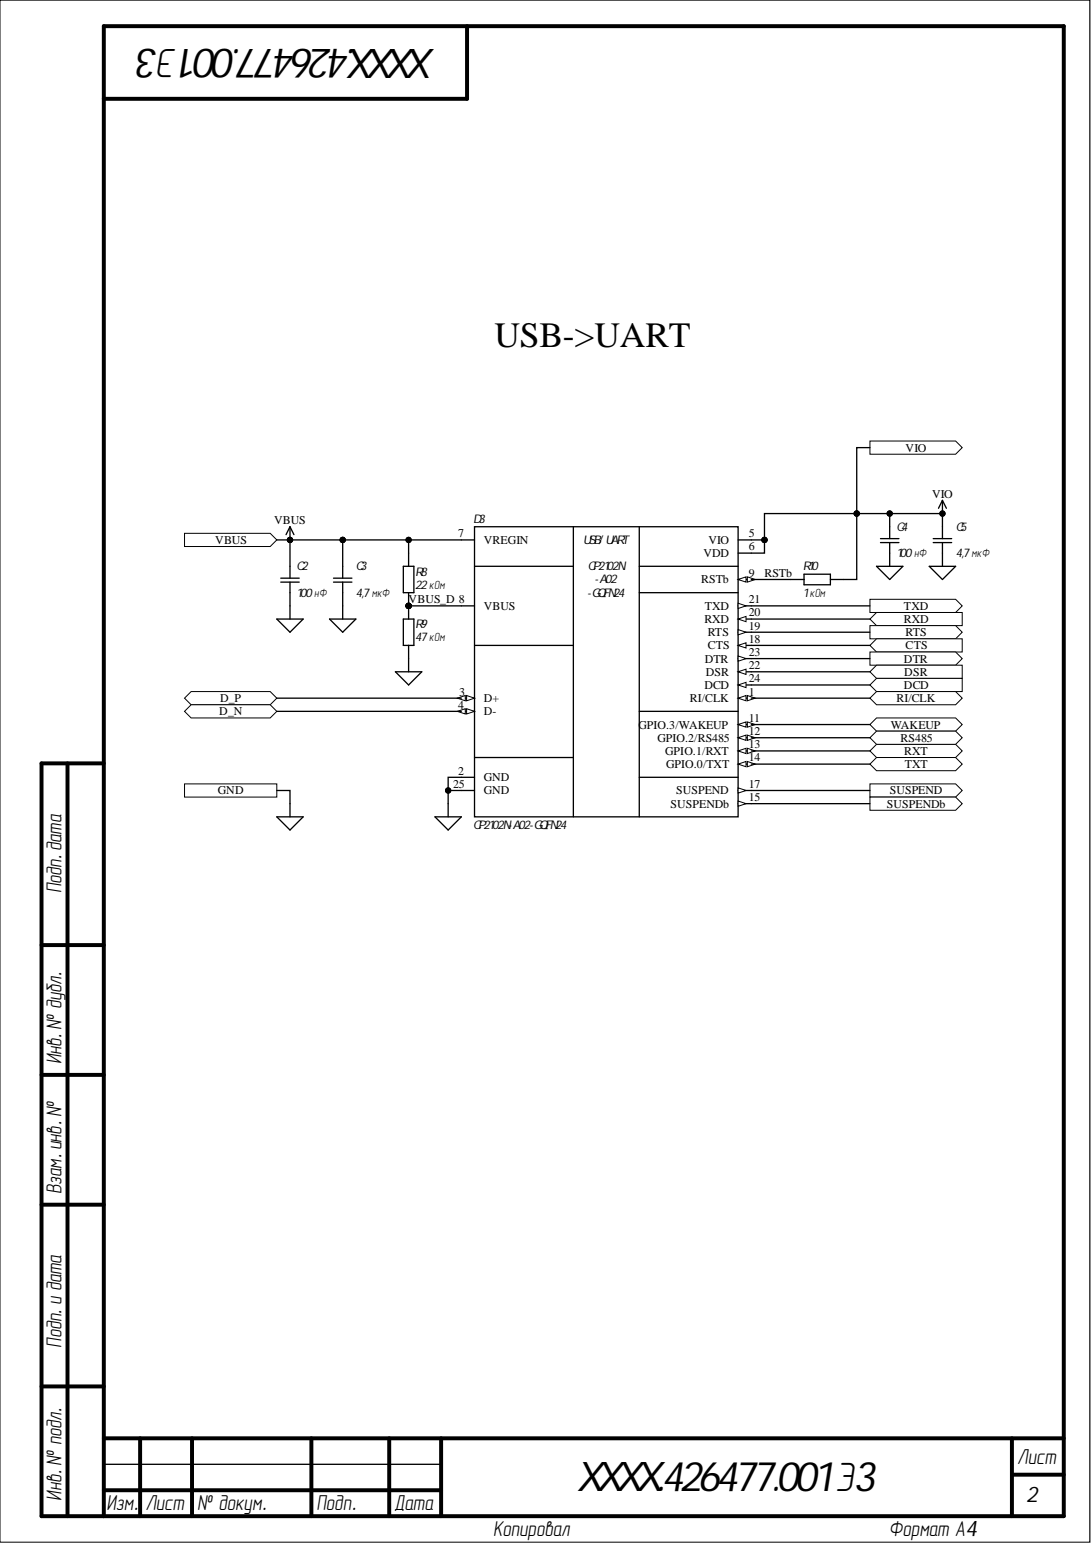
[picture p25: page 2]

Инв.№ подл. Подп.и дата Взам.инв.№ Инв.№ дубл. Подп.дата

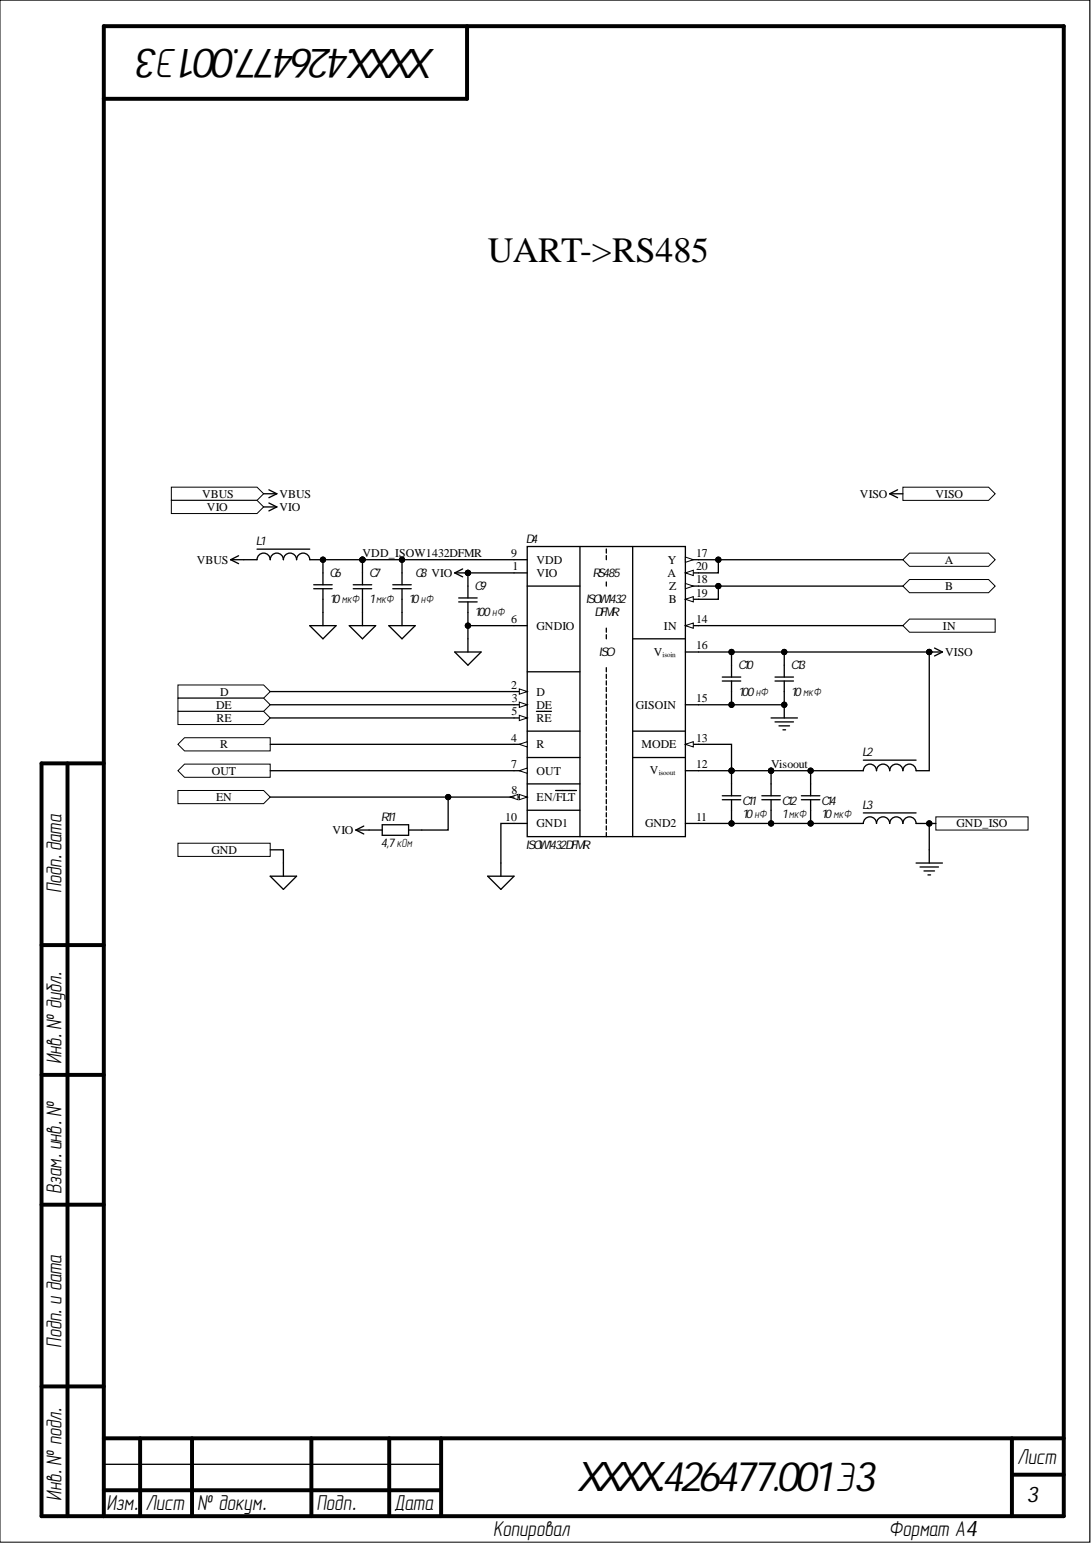
[picture p26: page 3]

O U T | V ᵢ ₛₒₒᵤ ₜ G N D 2

Инв.№ подл. Подп.и дата Взам.инв.№ Инв.№ дубл. Подп.дата
