nomatin/USB-RS485-Dongle/(list of files, drawings)

Other design files:
Board/PCB/PCB.PcbDoc
Board/SCH/MAIN.SchDoc
Board/SCH/UARTtoRS485.SchDoc
Board/SCH/USBtoUART.SchDoc
Board/USB_to_RS485.PrjPcb
USB_to_RS486.PrjPcb
