nomatin/USB-RS485-Dongle/(commit log)

2026-10-22 Add USB to schematic
    [MAIN.SchDoc, USB_to_UART.SchDoc]
2026-10-22 Add USB-to-UART block
    [MAIN.SchDoc, USB_to_UART.SchDoc]
2026-10-22 Add UART-to-RS485 block
    [MAIN.SchDoc, UARTtoRS485.SchDoc, USB_to_RS486.PrjPcb, USB_to_UART.SchDoc]
2026-10-26 Connect USB-UART and UART-RS485 blocks and update component database
    [MAIN.SchDoc, UARTtoRS485.SchDoc, USB_to_UART.SchDoc]
2026-10-26 Complete preliminary schematic
    [MAIN.SchDoc, UARTtoRS485.SchDoc, USB_to_RS486.PrjPcb, USB_to_UART.SchDoc]
2026-10-26 Add RS485 ESD protection, OutJob, and E3/PE3 documents
    Reorganize project directories.
    [MAIN.SchDoc, UARTtoRS485.SchDoc, USB_to_RS486.PrjPcb, USB_to_UART.SchDoc, Преобразователь USB–RS485 XXXX.426477.001 ПЭ3.xls]
2026-10-26 Rename project to USB_to_RS485 and add power LED
    [MAIN.SchDoc, UARTtoRS485.SchDoc, USB_to_RS485.PrjPcb, USB_to_UART.SchDoc, Преобразователь USB–RS485 XXXX.426477.001 ПЭ3.xls]
2026-10-27 Fix ISOW1432 grounding, add filters, and unify naming
    Update schematics, project settings, and output job; add the PCB document.
    [MAIN.SchDoc, PCB.PcbDoc, UARTtoRS485.SchDoc, USB_to_RS485.PrjPcb, USB_to_UART.SchDoc, USBtoUART.SchDoc]
2026-10-27 Обновлена КД
    [USB_to_RS485.PrjPcb, Преобразователь USB–RS485 XXXX.426477.001 ПЭ3.xls]
2026-11-01 Update LED, capacitor, and USB ESD pin mapping
    Refresh schematics, PCB, constraints, and component simulation models. Add simulation configuration and saved DRC reports.
    [MAIN.SchDoc, PCB.PcbDoc, UARTtoRS485.SchDoc, USB_to_RS485.PrjPcb, USBtoUART.SchDoc]
2026-11-01 Update PCB layout
    [PCB.PcbDoc]
2026-11-02 Update PCB, main schematic, and routing width constraints
    [MAIN.SchDoc, PCB.PcbDoc]
2026-11-02 Update schematics, PCB, and TXD/RXD routing constraints
    [MAIN.SchDoc, PCB.PcbDoc, UARTtoRS485.SchDoc, USBtoUART.SchDoc]
2026-11-02 Update PCB and USB-to-UART schematic
    [PCB.PcbDoc, USBtoUART.SchDoc]
2026-11-02 Update PCB, schematics, and net width constraints
    [MAIN.SchDoc, PCB.PcbDoc, USBtoUART.SchDoc]
2026-11-02 Update PCB, main schematic, and constraints
    [MAIN.SchDoc, PCB.PcbDoc]
2026-11-02 Update PCB, connection rules, and DRC reports
    [PCB.PcbDoc, UARTtoRS485.SchDoc]
2026-11-03 Resolve all DRC violations and update design reports
    [MAIN.SchDoc, PCB.PcbDoc, UARTtoRS485.SchDoc, USBtoUART.SchDoc]
2026-11-03 Reorganize board files and add enclosure CAD models
    [MAIN.SchDoc, PCB.DXF, PCB.PcbDoc, PCB.step, UARTtoRS485.SchDoc, USB_to_RS485.PrjPcb, USBtoUART.SchDoc, Преобразователь USB–RS485 XXXX.426477.001 ПЭ3.xls]
2026-11-04 Update PCB model and enclosure CAD components
    [PCB.PcbDoc, PCB.step]
2026-11-06 Update board and enclosure designs and add manufacturing outputs
    [Bill of Materials-USB_to_RS485.xlsx, MAIN.SchDoc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]
2026-11-06 Update enclosure models and add engineering drawings
    [MAIN.SchDoc, USB_to_RS485.PrjPcb, Преобразователь USB–RS485 XXXX.426477.001 ПЭ3.xls, Преобразователь USB–RS485 XXXX.426477.001.xls]
2026-11-08 Update enclosure assembly and mechanical drawings
2026-11-08 Document repository, board, and enclosure
2026-11-08 docs: rewrite main, board and enclosure README files
2026-11-09 Add PCB and enclosure illustrations
2026-11-09 docs: display PCB layers, 3D model and enclosure animation
2026-11-09 docs: show PCB 3D preview on home and layer views in Board README
